Genexiz/A-Flight-Controller-project/build/pcb_preview.png

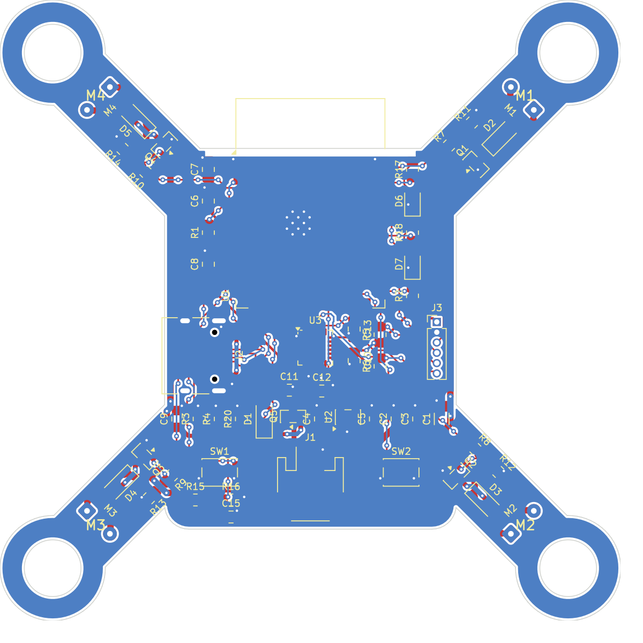
build/pcb_preview.png
