Genexiz/A-Flight-Controller-project/build/route.png

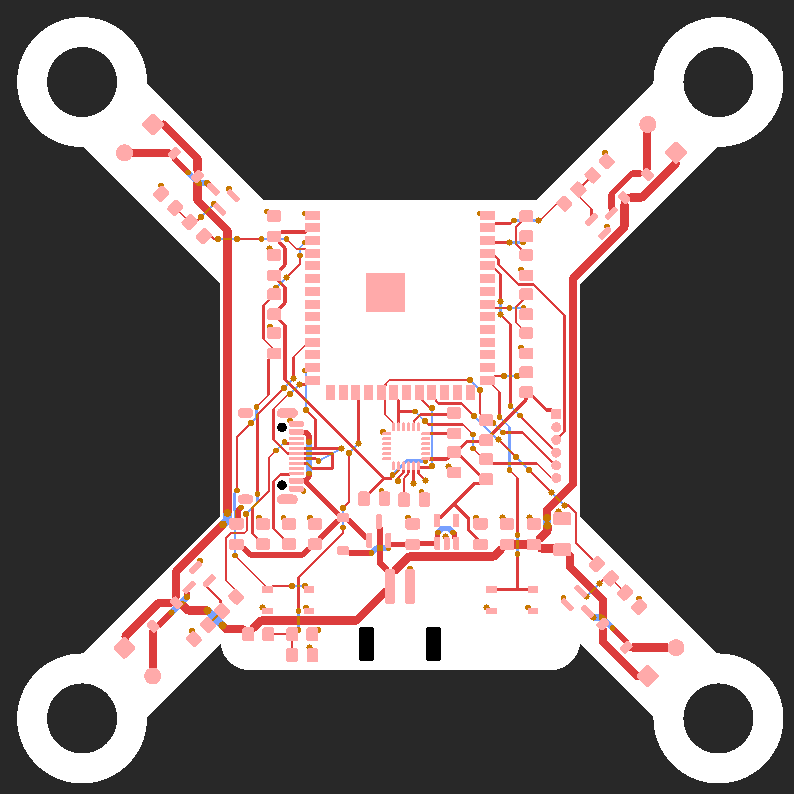
build/route.png
