Genexiz/A-Flight-Controller-project/build/route_dbg.png

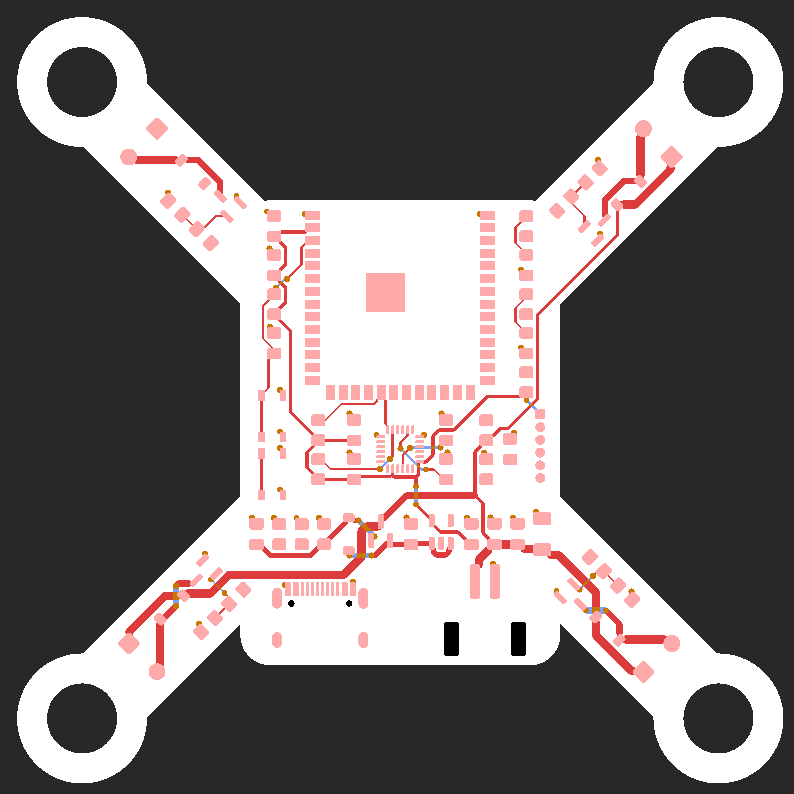
build/route_dbg.png
