Genexiz/A-Flight-Controller-project/(list of files, drawings)

Other design files:
build/pcb_analysis.json
