Genexiz/A-Flight-Controller-project/MiniDrone_FC.kicad_pcb

## KiCad design MiniDrone_FC.kicad_pcb (2026-10-19)

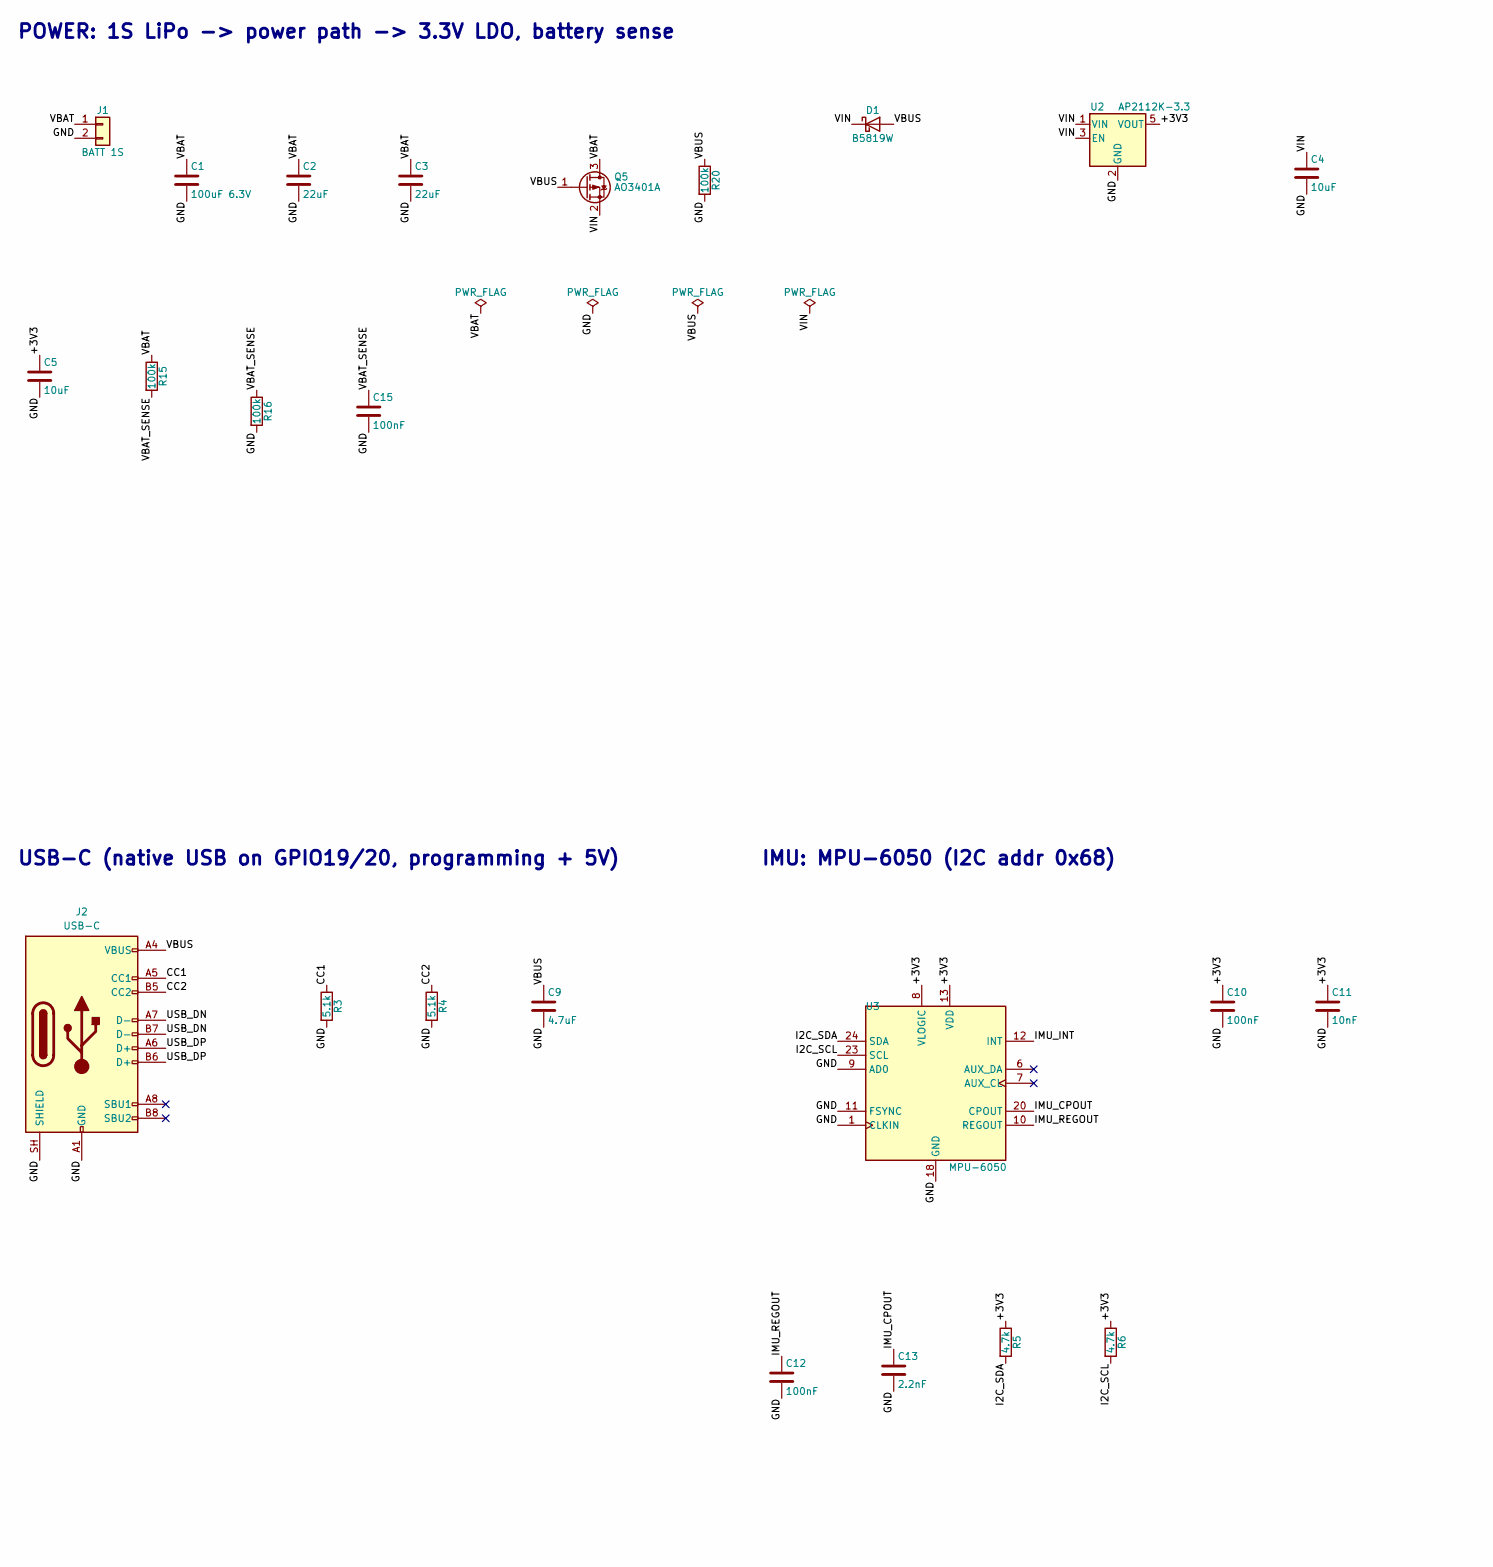
[picture p4: schematic MiniDrone_FC.kicad_sch, MiniDrone Flight Controller (ESP32-S3, brushed 1S), part in row 1, column 1]

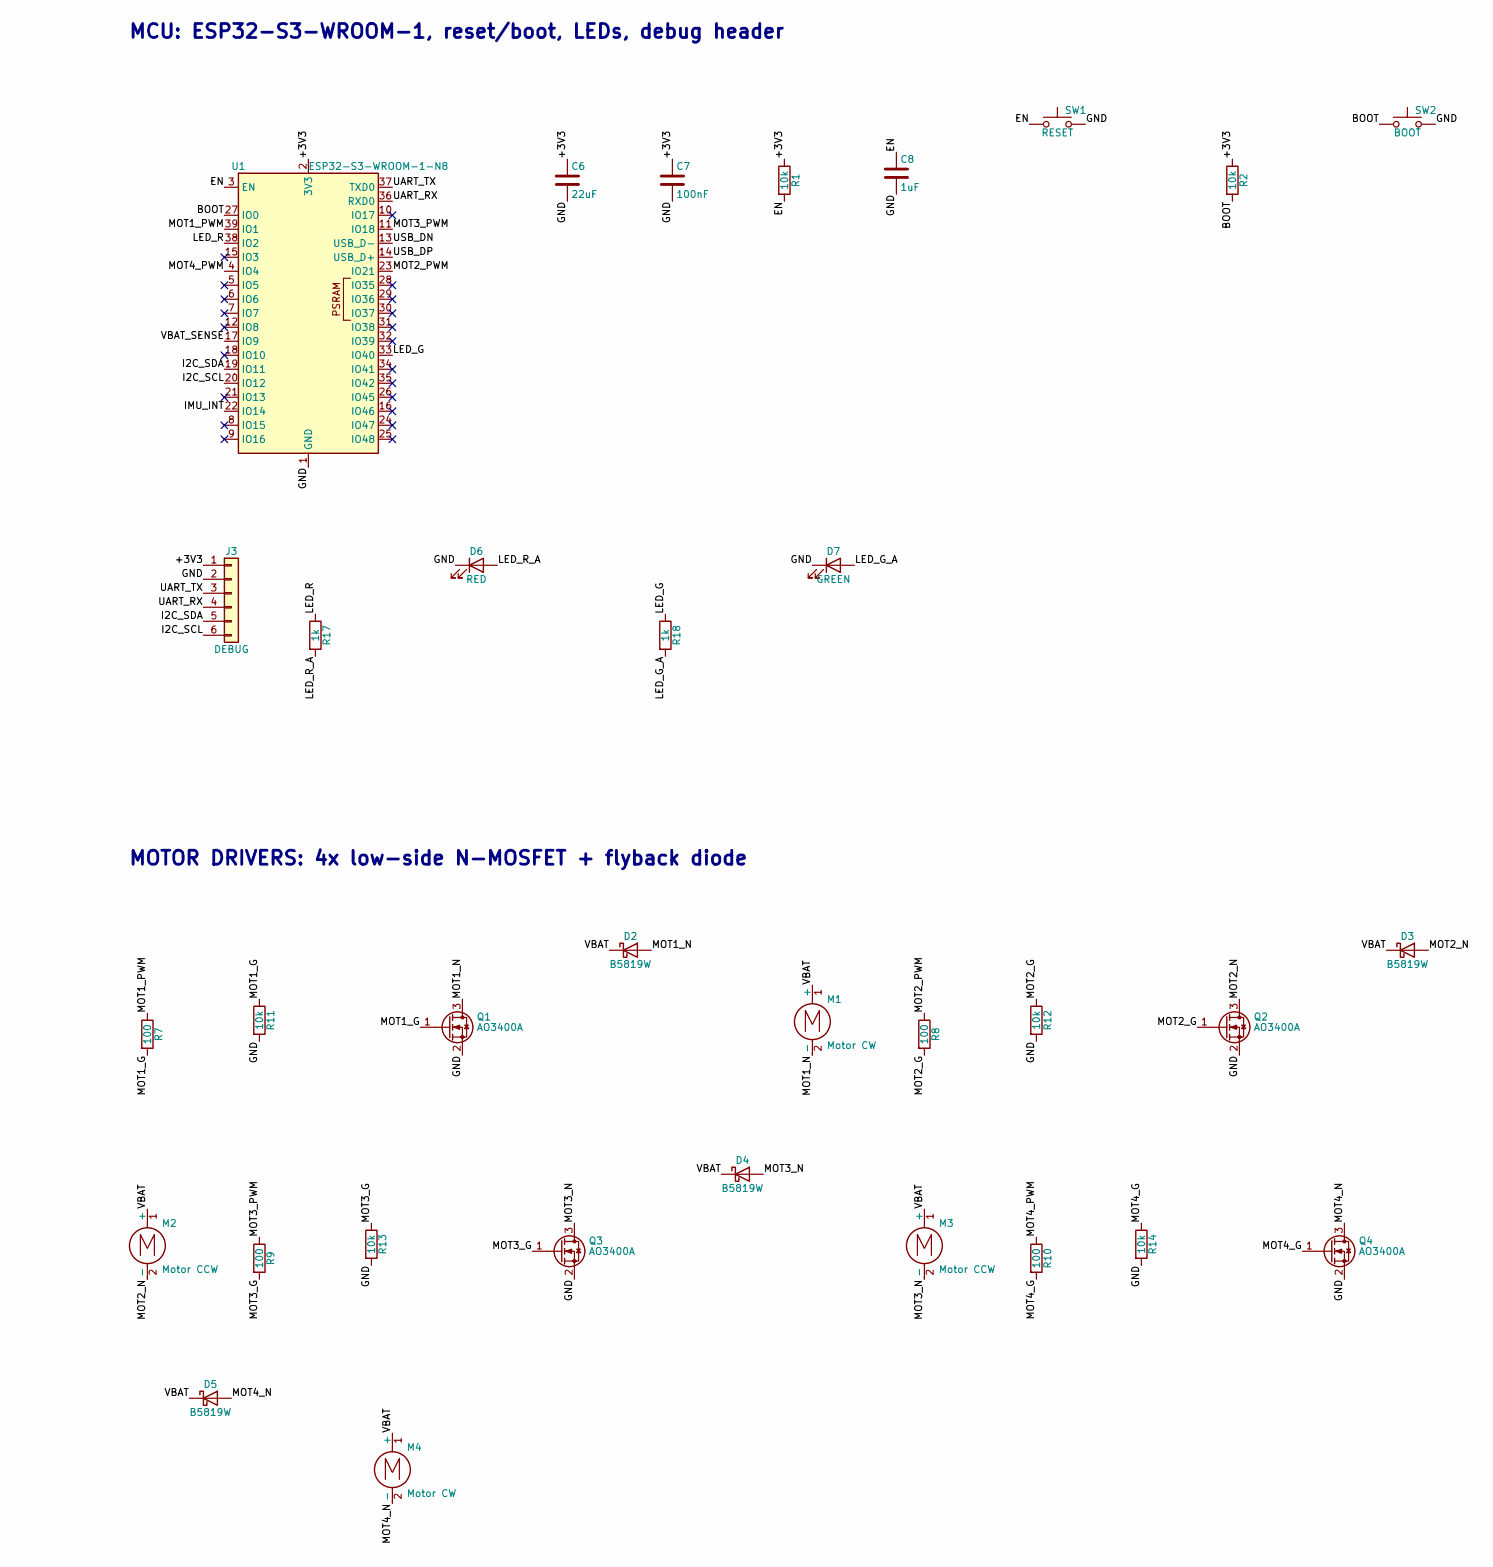
[picture p5: schematic MiniDrone_FC.kicad_sch, MiniDrone Flight Controller (ESP32-S3, brushed 1S), part in row 1, column 2]

Parts:
C1: 100uF 6.3V; C_1206_3216Metric_Pad1.33x1.80mm_HandSolder; MPN GRM31CR60J107ME39
C2, C3, C6: 22uF; C_0805_2012Metric_Pad1.18x1.45mm_HandSolder
C4, C5: 10uF; C_0805_2012Metric_Pad1.18x1.45mm_HandSolder
C7, C10, C12, C15: 100nF; C_0805_2012Metric_Pad1.18x1.45mm_HandSolder
C8: 1uF; C_0805_2012Metric_Pad1.18x1.45mm_HandSolder
C9: 4.7uF; C_0805_2012Metric_Pad1.18x1.45mm_HandSolder
C11: 10nF; C_0805_2012Metric_Pad1.18x1.45mm_HandSolder
C13: 2.2nF; C_0805_2012Metric_Pad1.18x1.45mm_HandSolder
D1, D2, D3, D4, D5: B5819W; D_SOD-123; MPN B5819W
D6: RED; LED_0805_2012Metric_Pad1.15x1.40mm_HandSolder
D7: GREEN; LED_0805_2012Metric_Pad1.15x1.40mm_HandSolder
J1: BATT 1S; JST_PH_S2B-PH-SM4-TB_1x02-1MP_P2.00mm_Horizontal; MPN S2B-PH-SM4-TB
J2: USB-C; USB_C_Receptacle_HRO_TYPE-C-31-M-12; MPN TYPE-C-31-M-12
J3: DEBUG; PinHeader_1x06_P1.27mm_Vertical
M1, M4: Motor CW; SolderWire-0.15sqmm_1x02_P4mm_D0.5mm_OD1.5mm
M2, M3: Motor CCW; SolderWire-0.15sqmm_1x02_P4mm_D0.5mm_OD1.5mm
Q1, Q2, Q3, Q4: AO3400A; SOT-23; MPN AO3400A
Q5: AO3401A; SOT-23; MPN AO3401A
R1, R2, R11, R12, R13, R14: 10k; R_0805_2012Metric_Pad1.20x1.40mm_HandSolder
R3, R4: 5.1k; R_0805_2012Metric_Pad1.20x1.40mm_HandSolder
R5, R6: 4.7k; R_0805_2012Metric_Pad1.20x1.40mm_HandSolder
R7, R8, R9, R10: 100; R_0805_2012Metric_Pad1.20x1.40mm_HandSolder
R15, R16, R20: 100k; R_0805_2012Metric_Pad1.20x1.40mm_HandSolder
R17, R18: 1k; R_0805_2012Metric_Pad1.20x1.40mm_HandSolder
SW1: RESET; SW_SPST_PTS810; MPN PTS810SJM250SMTRLFS
SW2: BOOT; SW_SPST_PTS810; MPN PTS810SJM250SMTRLFS
U1: ESP32-S3-WROOM-1-N8; ESP32-S3-WROOM-1; MPN ESP32-S3-WROOM-1-N8
U2: AP2112K-3.3; SOT-23-5; MPN AP2112K-3.3TRG1
U3: MPU-6050; InvenSense_QFN-24_4x4mm_P0.5mm; MPN MPU-6050

Connections:
/+3V3: C5.1, C6.1, C7.1, C10.1, C11.1, J3.1, R1.1, R2.1, R5.1, R6.1, U1.2 (3V3), U2.5 (VOUT), U3.8 (VLOGIC), U3.13 (VDD)
/BOOT: R2.2, SW2.1, U1.27 (IO0)
/CC1: J2.A5 (CC1), R3.1
/CC2: J2.B5 (CC2), R4.1
/EN: C8.1, R1.2, SW1.1, U1.3 (EN)
/GND: C1.2, C2.2, C3.2, C4.2, C5.2, C6.2, C7.2, C8.2, C9.2, C10.2, C11.2, C12.2, C13.2, C15.2, D6.1 (K), D7.1 (K), J1.2, J2.A1 (GND), J2.A12 (GND), J2.B1 (GND), J2.B12 (GND), J2.SH (SHIELD), J3.2, Q1.2 (S), Q2.2 (S), Q3.2 (S), Q4.2 (S), R3.2, R4.2, R11.2, R12.2, R13.2, R14.2, R16.2, R20.2, SW1.2, SW2.2, U1.1 (GND), U1.40 (GND), U1.41 (GND), U2.2 (GND), U3.1 (CLKIN), U3.9 (AD0), U3.11 (FSYNC), U3.18 (GND)
/I2C_SCL: J3.6, R6.2, U1.20 (IO12), U3.23 (SCL)
/I2C_SDA: J3.5, R5.2, U1.19 (IO11), U3.24 (SDA)
/IMU_CPOUT: C13.1, U3.20 (CPOUT)
/IMU_INT: U1.22 (IO14), U3.12 (INT)
/IMU_REGOUT: C12.1, U3.10 (REGOUT)
/LED_G: R18.1, U1.33 (IO40)
/LED_G_A: D7.2 (A), R18.2
/LED_R: R17.1, U1.38 (IO2)
/LED_R_A: D6.2 (A), R17.2
/MOT1_G: Q1.1 (G), R7.2, R11.1
/MOT1_N: D2.2 (A), M1.2 (-), Q1.3 (D)
/MOT1_PWM: R7.1, U1.39 (IO1)
/MOT2_G: Q2.1 (G), R8.2, R12.1
/MOT2_N: D3.2 (A), M2.2 (-), Q2.3 (D)
/MOT2_PWM: R8.1, U1.23 (IO21)
/MOT3_G: Q3.1 (G), R9.2, R13.1
/MOT3_N: D4.2 (A), M3.2 (-), Q3.3 (D)
/MOT3_PWM: R9.1, U1.11 (IO18)
/MOT4_G: Q4.1 (G), R10.2, R14.1
/MOT4_N: D5.2 (A), M4.2 (-), Q4.3 (D)
/MOT4_PWM: R10.1, U1.4 (IO4)
/UART_RX: J3.4, U1.36 (RXD0)
/UART_TX: J3.3, U1.37 (TXD0)
/USB_DN: J2.A7 (D-), J2.B7 (D-), U1.13 (USB_D-)
/USB_DP: J2.A6 (D+), J2.B6 (D+), U1.14 (USB_D+)
/VBAT: C1.1, C2.1, C3.1, D2.1 (K), D3.1 (K), D4.1 (K), D5.1 (K), J1.1, M1.1 (+), M2.1 (+), M3.1 (+), M4.1 (+), Q5.3 (D), R15.1
/VBAT_SENSE: C15.1, R15.2, R16.1, U1.17 (IO9)
/VBUS: C9.1, D1.2 (A), J2.A4 (VBUS), J2.A9 (VBUS), J2.B4 (VBUS), J2.B9 (VBUS), Q5.1 (G), R20.1
/VIN: C4.1, D1.1 (K), Q5.2 (S), U2.1 (VIN), U2.3 (EN)

Notes on the sheet:
POWER: 1S LiPo -> power path -> 3.3V LDO, battery sense
MCU: ESP32-S3-WROOM-1, reset/boot, LEDs, debug header
USB-C (native USB on GPIO19/20, programming + 5V)
IMU: MPU-6050 (I2C addr 0x68)
MOTOR DRIVERS: 4x low-side N-MOSFET + flyback diode

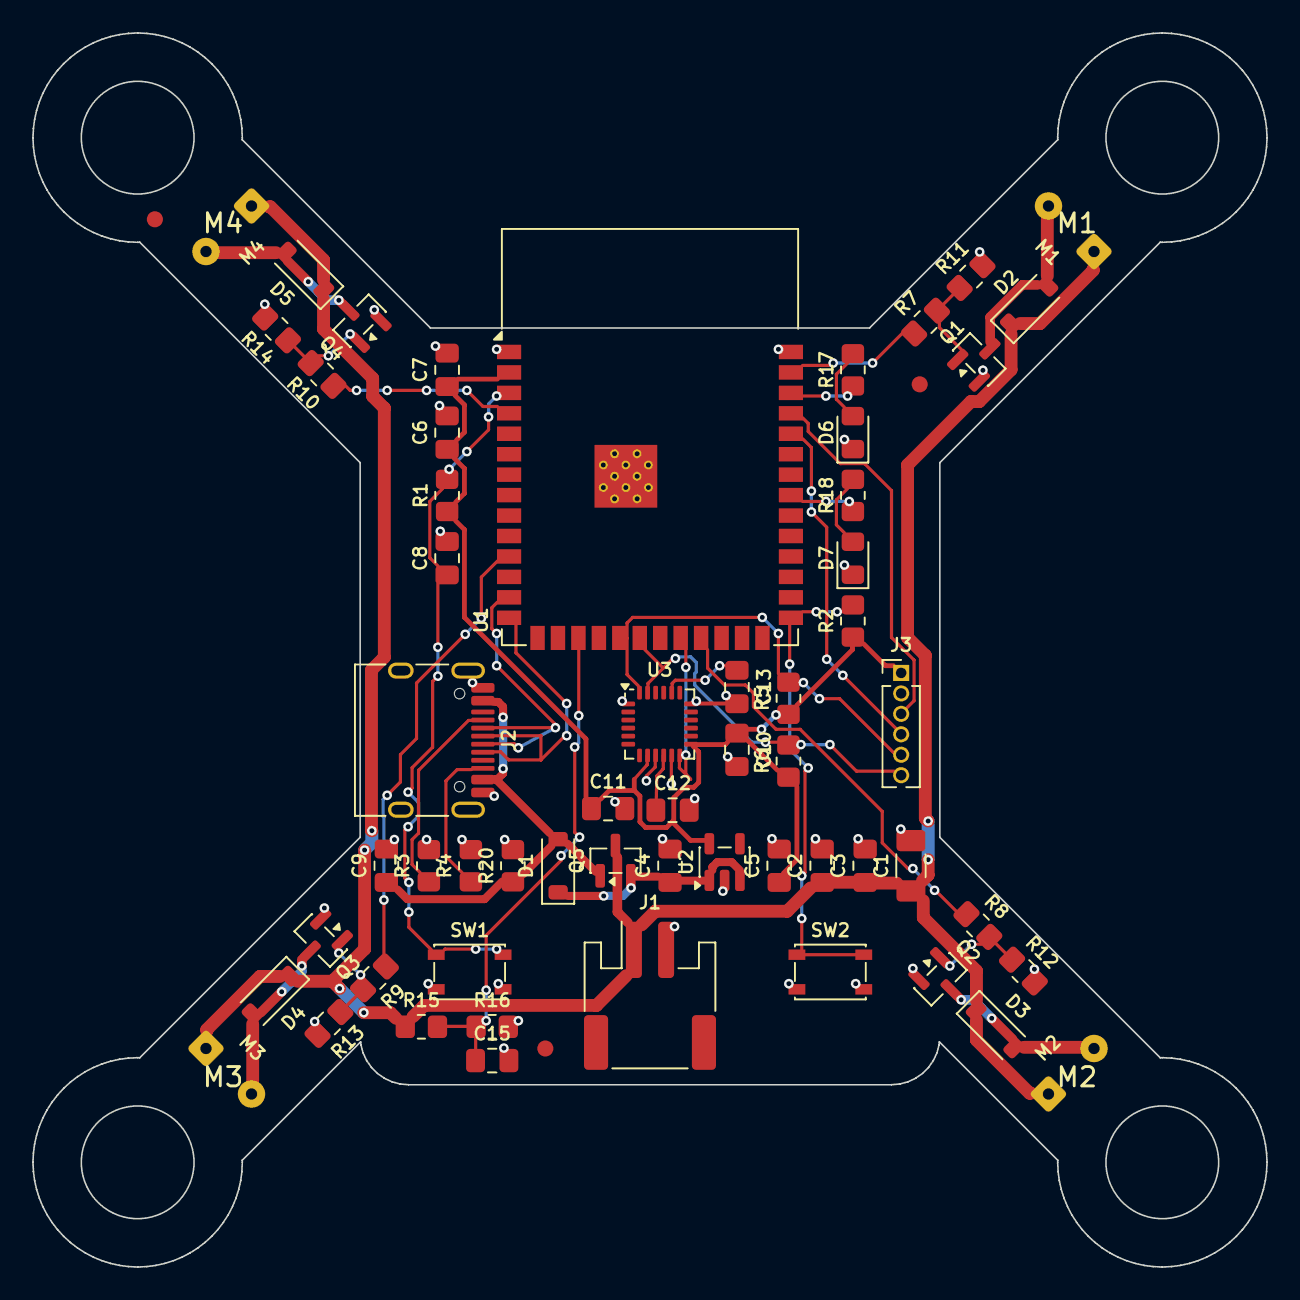
[picture p6: board MiniDrone_FC.kicad_pcb from above]

Board: 2 copper layers, 76.6 x 76.6 mm, 60 parts (0 on the bottom side), 35 nets.

Other parts of the board:
FID1, FID2, FID3: Fiducial_1mm_Mask2mm
