Genexiz/A-Flight-Controller-project/(commit log)

2026-10-19 Init push
    A Flight Controller
    [MiniDrone_FC.before_finish.kicad_pcb, MiniDrone_FC.kicad_pcb, MiniDrone_FC.kicad_sch, pcb_analysis.json]
2026-10-19 silk screen update
    [MiniDrone_FC.kicad_pcb]
